ikonis/OpenWatts/docs/hardware/README.md

# OpenWatts RevA hardware exports

These files are generated from the authoritative current-board KiCad sources:

- `OpenWatts-RevA-schematic.pdf` - printable schematic
- `OpenWatts-RevA-schematic.svg` - scalable schematic for browsers/GitHub
- `OpenWatts-RevA-schematic.png` - convenient schematic preview
- `OpenWatts-RevA-front.png` - populated front render
- `OpenWatts-RevA-back.png` - board-back render
- `OpenWatts-RevA-3d.png` - perspective populated-board render

They document the manufactured RevA board. Edit `OpenWatts.kicad_sch` or
`OpenWatts.kicad_pcb` as the source; do not edit these exports as substitutes
for KiCad changes.
