ikonis/OpenWatts/fab/pcbway-2026-07-06/gerbers/OpenWatts-drill-report.txt

Drill report for OpenWatts.kicad_pcb
Created on 2026-07-06T12:25:11

Copper Layer Stackup:
    =============================================================
    L1 :  F.Cu                      front
    L2 :  B.Cu                      back

Drill file 'OpenWatts-PTH.drl' contains
    plated through holes:
    =============================================================
    T1  0.300mm  0.0118"  (30 holes))
    T2  0.600mm  0.0236"  (4 holes)  (with 4 slots)
    T3  0.750mm  0.0295"  (2 holes))
    T4  0.950mm  0.0374"  (8 holes))
    T5  1.000mm  0.0394"  (6 holes))

    Total plated holes count 50

Drill file 'OpenWatts-NPTH.drl' contains
    unplated through holes:
    =============================================================
    T1  0.650mm  0.0256"  (2 holes))
    T2  2.700mm  0.1063"  (4 holes))

    Total unplated holes count 6
