ikonis/OpenWatts/docs/hardware/OpenWatts-RevA-back.png

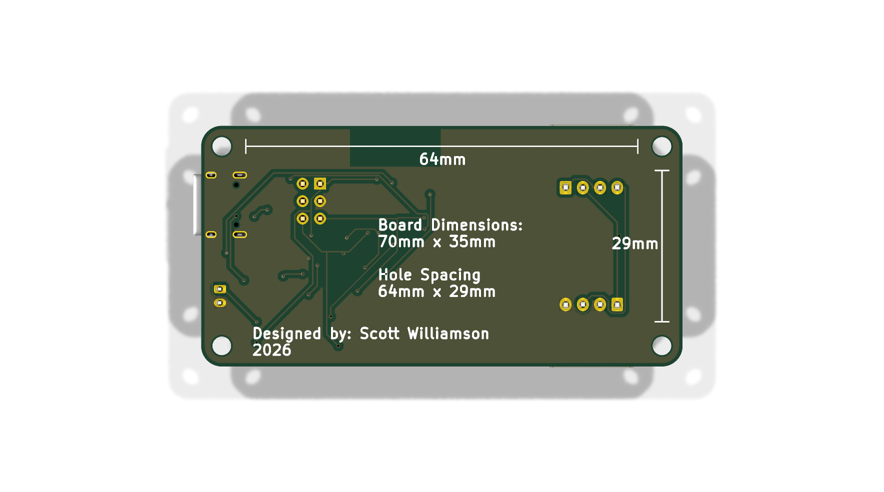
docs/hardware/OpenWatts-RevA-back.png
