ikonis/OpenWatts/docs/hardware/OpenWatts-RevA-front.png

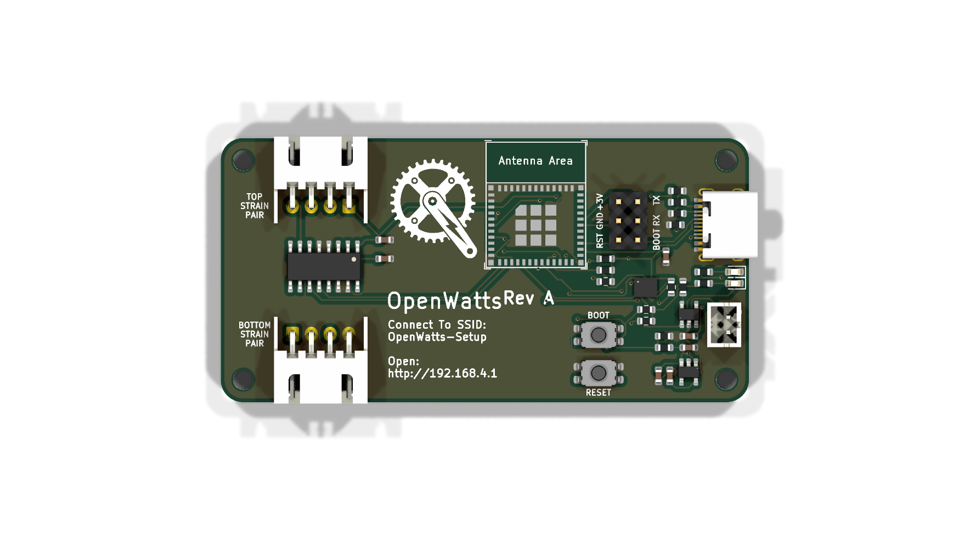
docs/hardware/OpenWatts-RevA-front.png
