ikonis/OpenWatts/docs/hardware/OpenWatts-RevA-schematic.png

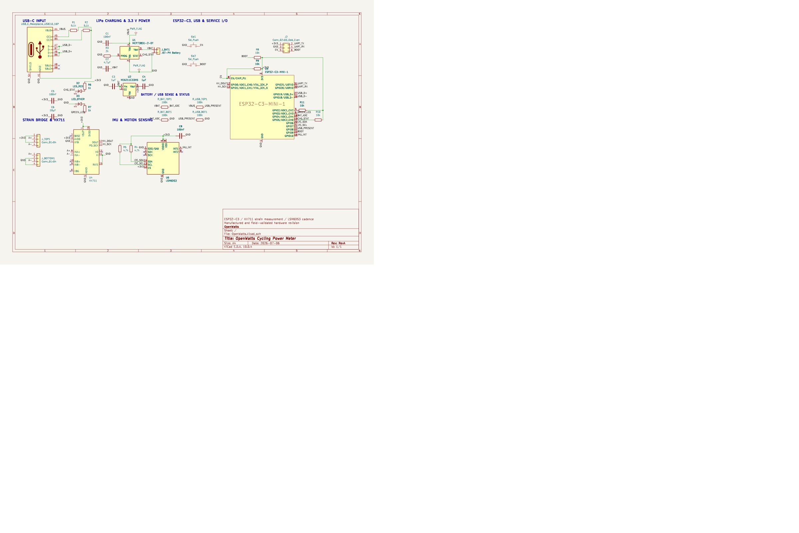
docs/hardware/OpenWatts-RevA-schematic.png
