ikonis/OpenWatts/3dmodels/USB_C_Receptacle_HRO_TYPE-C-31-M-12.step

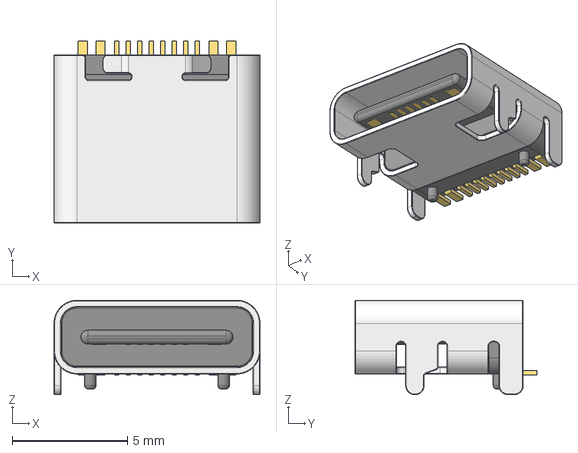
[picture p6: CAD file, 2026-07-06]
3dmodels/USB_C_Receptacle_HRO_TYPE-C-31-M-12.step
8.94 x 7.90 x 4.10 mm
