ikonis/OpenWatts/fab/pcbway-2026-07-06/3d/OpenWatts-board-only.step

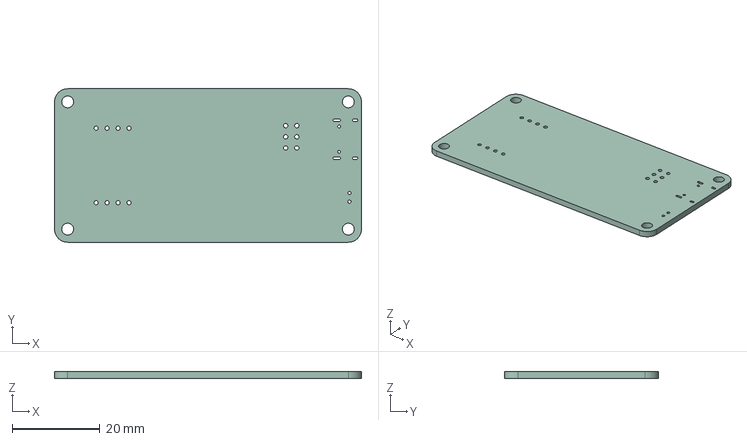
[picture p7: CAD file, 2026-07-06]
fab/pcbway-2026-07-06/3d/OpenWatts-board-only.step
70.0 x 35.0 x 1.51 mm
