ikonis/OpenWatts/mechanical/OW Case.3mf

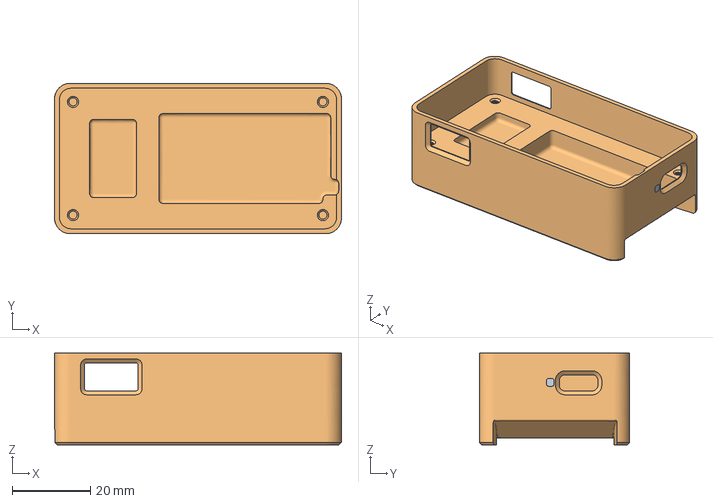
[picture p8: CAD file, 2026-08-10]
mechanical/OW Case.3mf
73.5 x 38.5 x 23.5 mm
Clear
OW Case
