ikonis/OpenWatts/fab/pcbway-2026-07-06/3d/OpenWatts.step

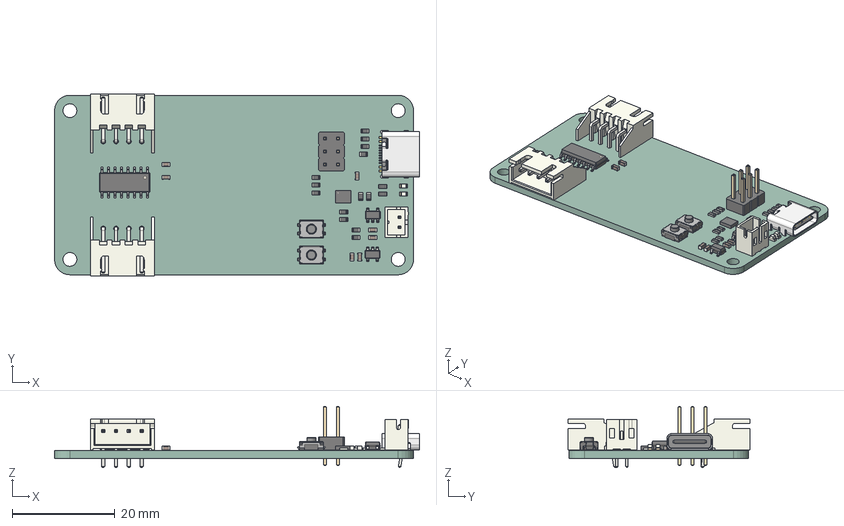
[picture p9: CAD file, 2026-07-06]
fab/pcbway-2026-07-06/3d/OpenWatts.step
71.2 x 35.4 x 11.9 mm
R_0603_1608Metric x 15
SOIC-16_3.9x9.9mm_P1.27mm
SOT-23-5 x 2
C_0603_1608Metric x 7
JST_S4B_XH_A x 2
LGA_14_3x25mm_P05mm_LayoutBorder3x4y
SW_SPST_EVQP2_MiddlePushTravel_H2.5mm x 2
JST_B2B_PH_K
LED_0603_1608Metric x 2
PinHeader_2x03_P254mm_Vertical
USB-C_SMD-TYPE-C-31-M-12
OpenWatts_PCB
