ikonis/OpenWatts/mechanical/OpenWatts_RevA_Enclosure.step

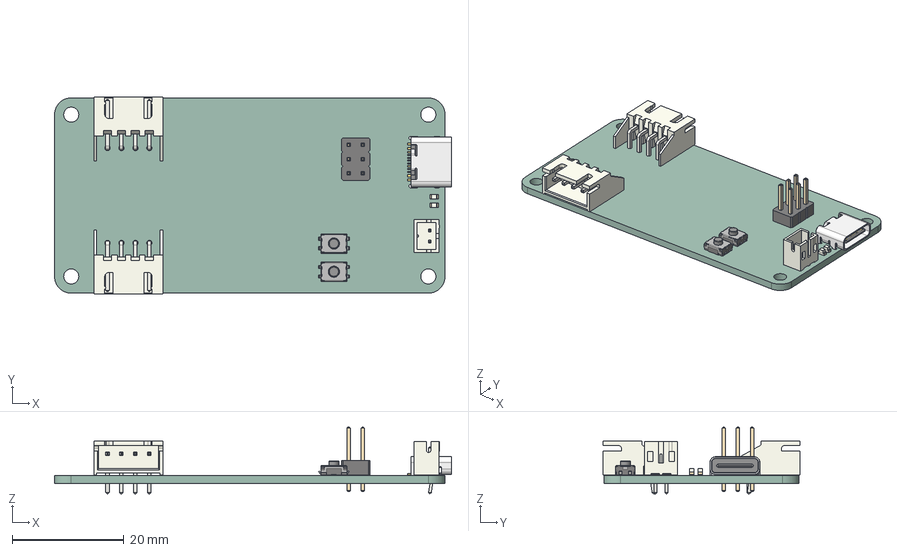
[picture p10: CAD file, 2026-08-10]
mechanical/OpenWatts_RevA_Enclosure.step
71.2 x 35.4 x 11.9 mm
JST_S4B_XH_A x 2
SW_SPST_EVQP2_MiddlePushTravel_H2.5mm x 2
JST_B2B_PH_K
LED_0603_1608Metric x 2
PinHeader_2x03_P254mm_Vertical
USB-C_SMD-TYPE-C-31-M-12
OpenWatts_PCB
