ikonis/OpenWatts/docs/hardware/OpenWatts-RevA-schematic.pdf

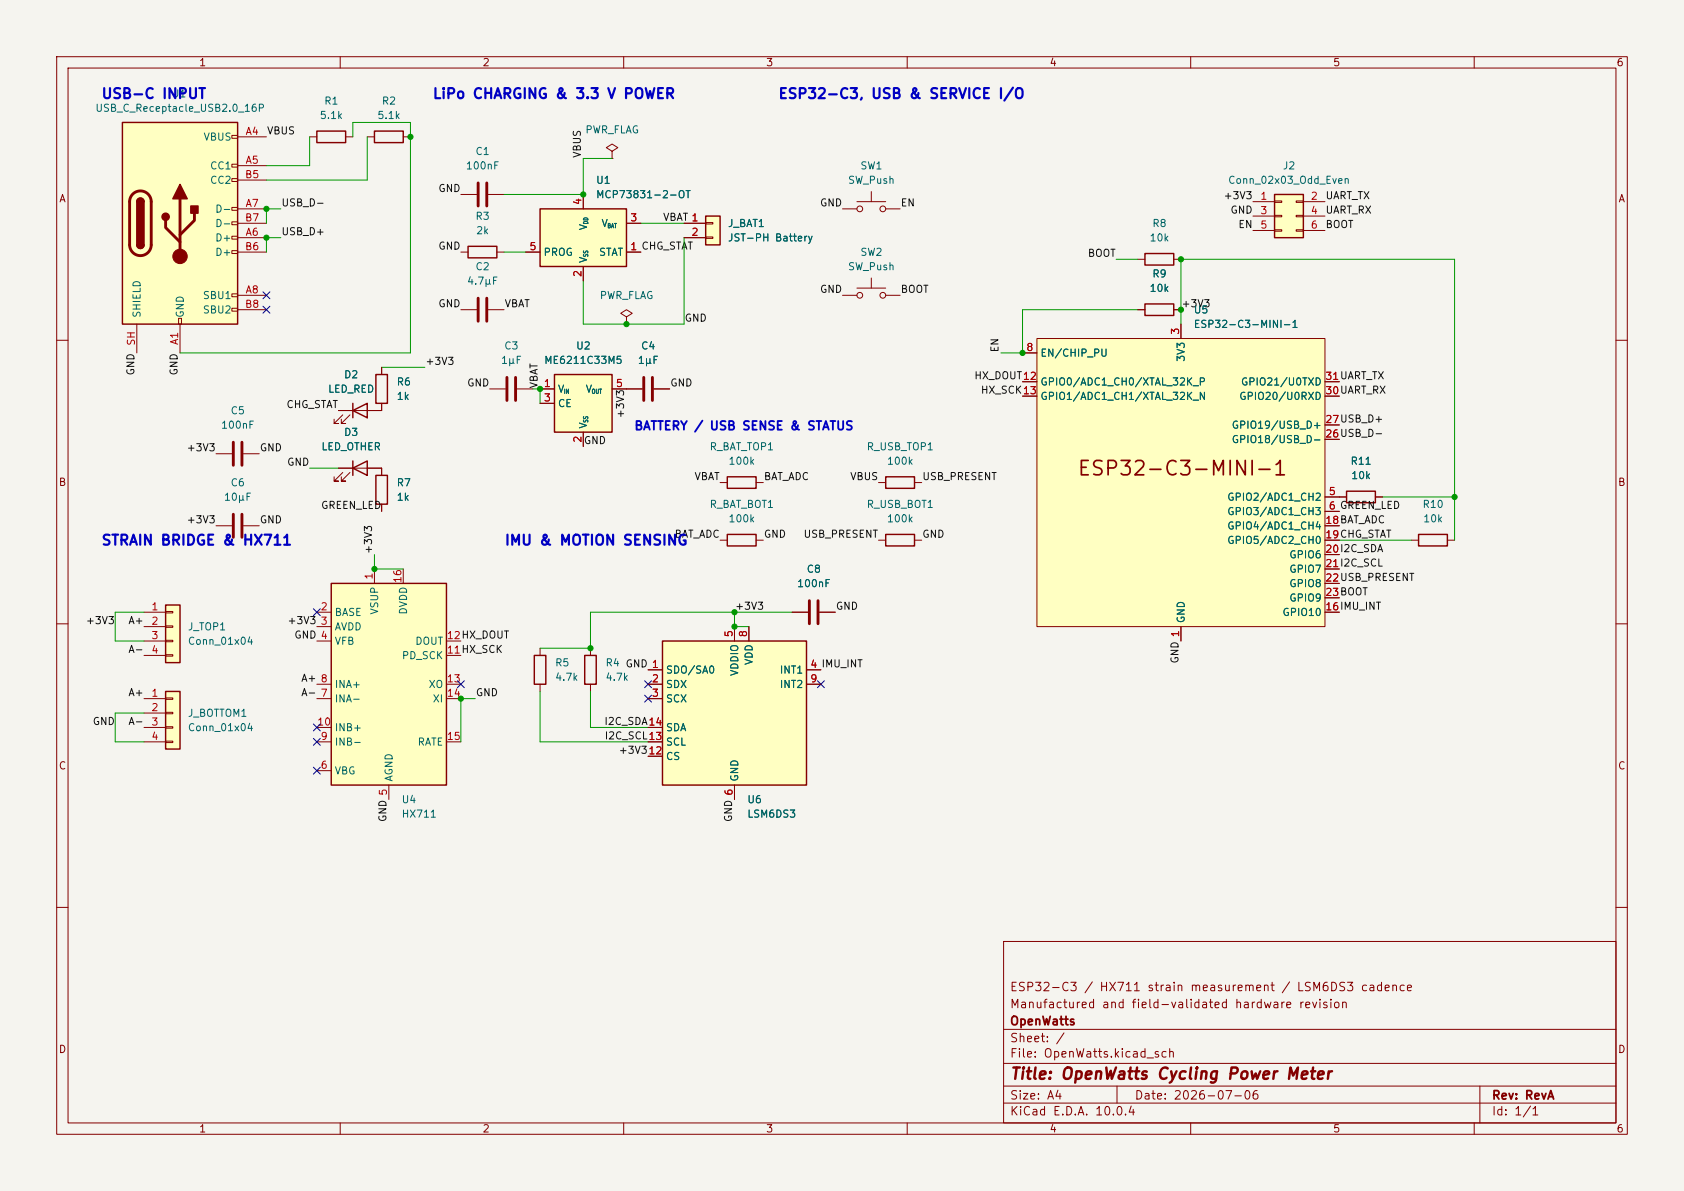
[picture p11: page 1]

BOOT BATTERY / USB SENSE & STATUS

XI 14 RATE 15 DVDD 16 U4HX711 GND A1

ESP32-C3 / HX711 strain measurement / LSM6DS3 cadence
Manufactured and field-validated hardware revision
OpenWatts
Sheet: /
File: OpenWatts.kicad_sch
Title: OpenWatts Cycling Power Meter

Size: A4 | Rev: RevA
KiCad E.D.A. 10.0.4 | Id: 1/1
