ikonis/OpenWatts/OpenWatts.kicad_pcb

## KiCad design OpenWatts.kicad_pcb (2026-07-06)

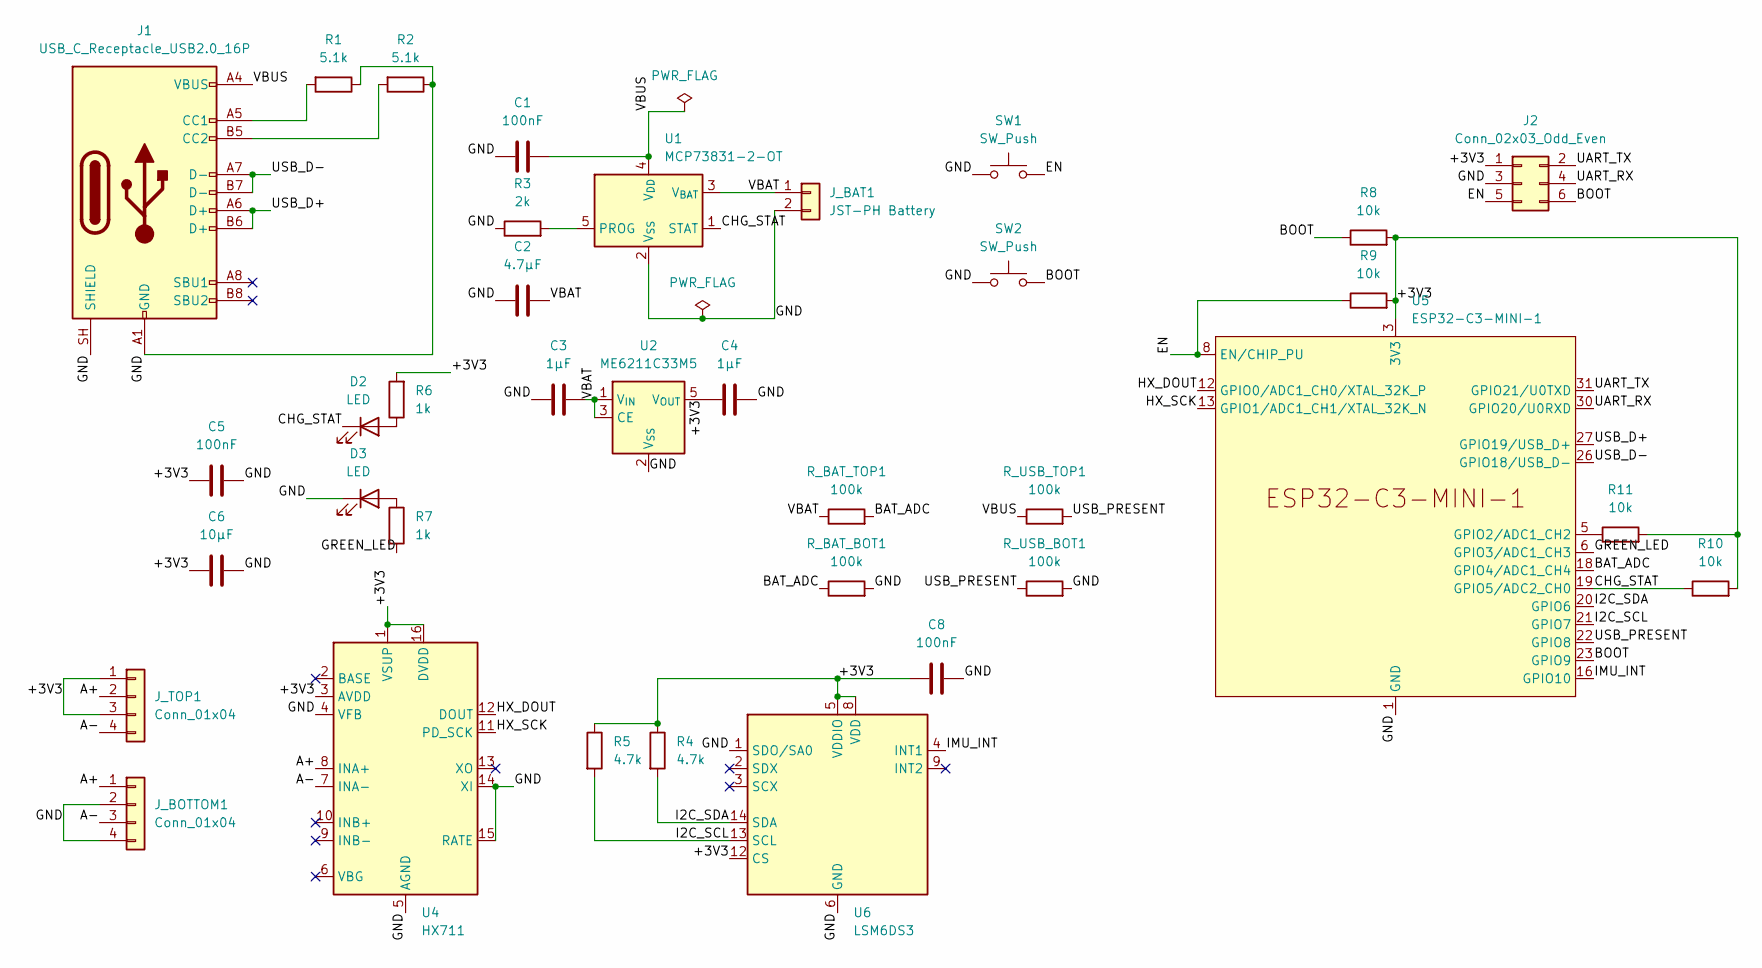
[picture p12: schematic OpenWatts.kicad_sch]

Parts:
C1, C5, C8: 100nF; C_0603_1608Metric
C2: 4.7µF; C_0603_1608Metric
C3, C4: 1µF; C_0603_1608Metric
C6: 10µF; C_0603_1608Metric
D2, D3: LED; LED_0603_1608Metric
J1: USB_C_Receptacle_USB2.0_16P; USB_C_Receptacle_HRO_TYPE-C-31-M-12
J2: Conn_02x03_Odd_Even; PinHeader_2x03_P2.54mm_Vertical
J_BAT1: JST-PH Battery; JST_PH_B2B-PH-K_1x02_P2.00mm_Vertical
J_BOTTOM1: Conn_01x04; JST_XH_S4B-XH-A_1x04_P2.50mm_Horizontal
J_TOP1: Conn_01x04; JST_XH_S4B-XH-A_1x04_P2.50mm_Horizontal
R1, R2: 5.1k; R_0603_1608Metric
R3: 2k; R_0603_1608Metric
R4, R5: 4.7k; R_0603_1608Metric
R6, R7: 1k; R_0603_1608Metric
R8, R9, R10, R11: 10k; R_0603_1608Metric
R_BAT_BOT1: 100k; R_0603_1608Metric
R_BAT_TOP1: 100k; R_0603_1608Metric
R_USB_BOT1: 100k; R_0603_1608Metric
R_USB_TOP1: 100k; R_0603_1608Metric
SW1, SW2: SW_Push; SW_SPST_EVQP2_MiddlePushTravel_H2.5mm
U1: MCP73831-2-OT; SOT-23-5
U2: ME6211C33M5; SOT-23-5
U4: HX711; SOIC-16_3.9x9.9mm_P1.27mm
U5: ESP32-C3-MINI-1
U6: LSM6DS3; LGA-14_3x2.5mm_P0.5mm_LayoutBorder3x4y

Connections:
/+3V3: C4.1, C5.1, C6.1, C8.1, J2.1, J_TOP1.1, J_TOP1.3, R4.1, R5.1, R6.2, R8.2, R9.2, R10.2, R11.2, U2.5 (V_{OUT}), U4.1 (VSUP), U4.3 (AVDD), U4.16 (DVDD), U5.3 (3V3), U6.5 (VDDIO), U6.8 (VDD), U6.12 (CS)
/A+: J_BOTTOM1.1, J_TOP1.2, U4.8 (INA+)
/A-: J_BOTTOM1.3, J_TOP1.4, U4.7 (INA-)
/BAT_ADC: R_BAT_BOT1.1, R_BAT_TOP1.2, U5.18 (GPIO4/ADC1_CH4)
/BOOT: J2.6, R8.1, SW2.2, U5.23 (GPIO9)
/CHG_STAT: D2.1 (K), R10.1, U1.1 (STAT), U5.19 (GPIO5/ADC2_CH0)
/EN: J2.5, R9.1, SW1.2, U5.8 (EN/CHIP_PU)
/GND: C1.1, C2.2, C3.1, C4.2, C5.2, C6.2, C8.2, D3.1 (K), J1.A1 (GND), J1.A12 (GND), J1.B1 (GND), J1.B12 (GND), J1.SH (SHIELD), J2.3, J_BAT1.2, J_BOTTOM1.2, J_BOTTOM1.4, R1.1, R2.1, R3.1, R_BAT_BOT1.2, R_USB_BOT1.2, SW1.1, SW2.1, U1.2 (V_{SS}), U2.2 (V_{SS}), U4.4 (VFB), U4.5 (AGND), U4.14 (XI), U4.15 (RATE), U5.1 (GND), U5.2 (GND), U5.11 (GND), U5.14 (GND), U5.36 (GND), U5.37 (GND), U5.38 (GND), U5.39 (GND), U5.40 (GND), U5.41 (GND), U5.42 (GND), U5.43 (GND), U5.44 (GND), U5.45 (GND), U5.46 (GND), U5.47 (GND), U5.48 (GND), U5.49 (GND), U5.50 (GND), U5.51 (GND), U5.52 (GND), U5.53 (GND), U6.1 (SDO/SA0), U6.6 (GND), U6.7 (GND)
/GREEN_LED: R7.2, U5.6 (GPIO3/ADC1_CH3)
/HX_DOUT: U4.12 (DOUT), U5.12 (GPIO0/ADC1_CH0/XTAL_32K_P)
/HX_SCK: U4.11 (PD_SCK), U5.13 (GPIO1/ADC1_CH1/XTAL_32K_N)
/I2C_SCL: R5.2, U5.21 (GPIO7), U6.13 (SCL)
/I2C_SDA: R4.2, U5.20 (GPIO6), U6.14 (SDA)
/IMU_INT: U5.16 (GPIO10), U6.4 (INT1)
/UART_RX: J2.4, U5.30 (GPIO20/U0RXD)
/UART_TX: J2.2, U5.31 (GPIO21/U0TXD)
/USB_D+: J1.A6 (D+), J1.B6 (D+), U5.27 (GPIO19/USB_D+)
/USB_D-: J1.A7 (D-), J1.B7 (D-), U5.26 (GPIO18/USB_D-)
/USB_PRESENT: R_USB_BOT1.1, R_USB_TOP1.2, U5.22 (GPIO8)
/VBAT: C2.1, C3.2, J_BAT1.1, R_BAT_TOP1.1, U1.3 (V_{BAT}), U2.1 (V_{IN}), U2.3 (CE)
/VBUS: C1.2, J1.A4 (VBUS), J1.A9 (VBUS), J1.B4 (VBUS), J1.B9 (VBUS), R_USB_TOP1.1, U1.4 (V_{DD})
unnamed: D2.2 (A), R6.1
unnamed: D3.2 (A), R7.1
unnamed: J1.A5 (CC1), R1.2
unnamed: J1.B5 (CC2), R2.2
unnamed: R3.2, U1.5 (PROG)
unnamed: R11.1, U5.5 (GPIO2/ADC1_CH2)

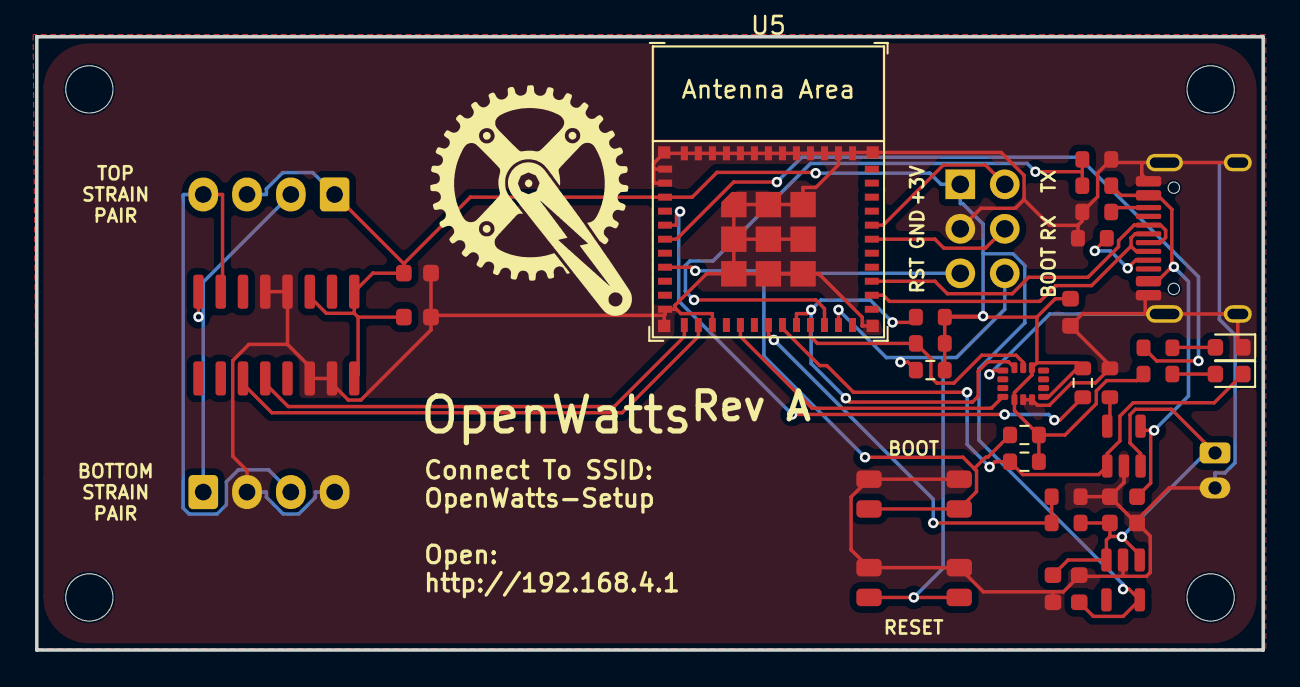
[picture p13: board OpenWatts.kicad_pcb from above]

Board: 2 copper layers, 70.0 x 35.0 mm, 40 parts (0 on the bottom side), 27 nets.

Other parts of the board:
H1, H2, H3, H4: MountingHole_2.7mm_M2.5
