ikonis/OpenWatts/firmware/logo_asset.cpp

#include "logo_asset.h"

namespace openwatts::webui {

const char kLogoSvg[] = R"OWSVG(<svg xmlns="http://www.w3.org/2000/svg" viewBox="-6.286433 -6.928326 12.505216 14.162086" fill="currentColor">
<path d="M -2.51636,-1.243183 L -2.44591,-1.273985 L -2.391271,-1.32609 L -2.355731,-1.393018 L -2.345133,-1.462328 L -2.356549,-1.529495 L -2.387047,-1.589994 L -2.433696,-1.6393 L -2.493568,-1.672888 L -2.56373,-1.686233 L -2.620708,-1.68038 L -2.691601,-1.651454 L -2.745989,-1.599748 L -2.772223,-1.55571 L -2.794392,-1.480759 L -2.79074,-1.40794 L -2.764022,-1.342221 L -2.716993,-1.288569 L -2.652408,-1.251951 L -2.596487,-1.238911 Z"/>
<path d="M -2.515681,4.069298 L -2.454675,4.045565 L -2.404457,4.005514 L -2.367293,3.953187 L -2.345451,3.892624 L -2.3412,3.827866 L -2.356806,3.762954 L -2.394537,3.701928 L -2.440927,3.659521 L -2.49164,3.636216 L -2.555002,3.625201 L -2.616853,3.628463 L -2.633053,3.63254 L -2.698402,3.667321 L -2.747795,3.722845 L -2.77778,3.794004 L -2.785475,3.858106 L -2.773916,3.935769 L -2.738974,3.996884 L -2.680051,4.042379 L -2.660985,4.051651 L -2.585207,4.072674 Z"/>
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
</svg>
)OWSVG";

}  // namespace openwatts::webui
