ikonis/OpenWatts/firmware/src/settings_storage.h

#pragma once

#include "config.h"
#include "ride_log.h"
#include "esp_err.h"

namespace openwatts {

class SettingsStorage {
public:
    esp_err_t begin();
    DeviceConfig load();
    esp_err_t save(const DeviceConfig &config);
    esp_err_t markSelfTestDone(DeviceConfig &config);
    LastRideSummary loadLastRide();
    esp_err_t saveLastRide(const LastRideSummary &summary);

private:
    bool initialized_ = false;
};

}  // namespace openwatts
