ikonis/OpenWatts/firmware/src/web_ui.h

#pragma once

namespace openwatts::webui {

extern const char kStatusPage[];
extern const char kRidePage[];
extern const char kSettingsPage[];
extern const char kCalibrationPage[];
extern const char kOtaPage[];
extern const char kDiagnosticsPage[];

}  // namespace openwatts::webui
