ikonis/OpenWatts/(commit log)

2026-07-06 Initial OpenWatts fabrication package
    [OpenWatts-BOM.csv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]
2026-07-06 Add OpenWatts firmware scaffold
    [partitions.csv]
2026-07-06 Ignore local KiCad lock files
2026-07-06 Add OpenWatts production export files
    [bom.csv, designators.csv, positions.csv]
2026-07-25 Checkpoint OpenWatts motion-wake firmware and board outputs
    [OpenWatts.kicad_sch, bom.csv]
2026-07-28 v0.2.0 - Establish OpenWatts parity architecture
    - Pin ESP32-C3 ESP-IDF and RISC-V toolchain versions
    - Add shared runtime, battery, and report policy contracts
    - Harden CPS power encoding and reject invalid samples before filtering
    - Add replaceable median/EMA power estimator
    - Preserve v3 credentials and calibration through NVS v4 migration
    - Scaffold honest IMU rotation and completed-revolution interfaces
    - Add architecture tests and hardware validation documentation
    [battery_policy.cpp, battery_policy.h, ble_cycling_power.cpp, ble_cycling_power.h, cadence_estimator.cpp, cadence_estimator.h, config.h, main.cpp]
2026-08-06 Checkpoint validated OpenWatts bring-up and configuration parity
    [partitions.csv]
2026-08-06 Establish OpenWatts pre-install firmware baseline
    - Add persistent Normal and Maintenance operating modes
    - Complete maintenance WebUI, calibration, OTA, diagnostics, and branding
    - Add IMU tuning and installation validation scaffolding
    - Preserve battery reporting, sleep, BLE, and sensor runtime behavior
    - Document and test the pre-install architecture
2026-08-10 Checkpoint OpenWatts pre-calibration bring-up
    - Preserve validated USB, Wi-Fi, motion wake, WebUI, and LED behavior
    - Add current installation documentation and mechanical exports
    - Correct HX711 readiness accounting and measured sample telemetry
    [OW Case.3mf, OpenWatts_RevA_Assembly.step, OpenWatts_RevA_Enclosure.step]
2026-08-11 OpenWatts 0.9-rc1 pre-install firmware
    - clean obsolete prototype and bench-test paths
    - wire persistent product settings into runtime behavior
    - add calibration-gated Ride Zero and Last Ride history
    - publish retained Last Ride metrics through MQTT discovery
    - add OpenWatts Home Assistant documentation
    - validate product and diagnostic builds
2026-08-11 Release OpenWatts 1.0.0 with guarded battery OTA
2026-08-11 Release OpenWatts 1.0.10 ride stability and road estimates
    - stabilize IMU cadence across transient read failures and reverse spikes
    - make Ride Zero lifecycle-aware and avoid repeated NVS writes
    - allow Manual Tare from the normal Status interface
    - add reproducible flat-road speed and distance estimates
    - add Imperial/Metric presentation with SI-native MQTT telemetry
    - migrate configuration and legacy Last Ride records safely
    - expand firmware tests and current architecture documentation
    [cadence_estimator.cpp, cadence_estimator.h, config.h, main.cpp, mqtt_notifier.cpp, mqtt_notifier.h, power_estimator.cpp]
2026-08-12 checkpoint: preserve validated OpenWatts pre-cleanup state
    Capture the working cadence and BLE diagnostics, ESP32-C3 gyro-range correction, and bounded post-ride MQTT publication behavior before the production cleanup pass.
    [ble_cycling_power.cpp, ble_cycling_power.h, cadence_estimator.cpp, cadence_estimator.h, config.h, imu_lsm6ds3.cpp, main.cpp]
2026-08-12 Release OpenWatts 1.0.12 production cleanup
    - preserve bounded post-ride MQTT delivery before sleep
    - remove unused runtime and rotation prototype modules
    - refresh architecture, installation, Home Assistant, and firmware documentation
    - remove the development-only installation checklist from the device UI
    - retain deployed NVS layout compatibility and calibration data
    - update tests to cover the active IMU cadence architecture
2026-08-12 Add live OpenWatts ride dashboard
    - expose current ride time, distance, and modeled speed
    - keep Normal-mode Wi-Fi available for qualified rides
    - poll SmartSpin2K runtime data directly from the browser
    - add a compact phone-first Ride page with safe fallback values
    - preserve BLE CPS and existing post-ride sleep/report lifecycle
2026-08-14 v1.1.0 - Mark OpenWatts as a working product
    - Remove unused SmartSpin2K target resistance display
    - Promote the validated RevA firmware to 1.1.0
    - Refresh documentation for current ride, OTA, MQTT, and validation behavior
    - Establish the post-installation product baseline
2026-08-14 Present OpenWatts RevA for public release
    - Add a concise public README and human-readable RevA BOM
    - Polish the schematic with functional headings and manufactured-board metadata
    - Add PDF, SVG, front, back, and 3D public hardware assets
    - Preserve evidence-based future hardware lessons in isolated RevB notes
    - Remove local KiCad sessions, redundant exports, and unused artwork
    - Keep the manufactured PCB and electrical connectivity unchanged
    [OpenWatts.dsn, OpenWatts.kicad_sch]
2026-08-14 Remove deployment-specific MQTT broker default
    [config.h]
2026-08-31 WIP: calibration drift investigation and UI updates
    [openwatts-imu-capture (1).csv, openwatts-imu-capture (2).csv]
2026-08-31 Add in-ride sliding zero correction for strain drift
    Tracks the per-revolution dead-spot torque minimum as a proxy for zero
    drift while riding, applying a bounded, gradually-walked correction on
    top of the permanent calibration. Exposes a ride log over HTTP for
    diagnostics.
    [config.h, main.cpp, power_estimator.cpp, power_estimator.h, setup_wifi.cpp, setup_wifi.h]
2026-08-31 Remove accidental local artifacts from repo
    nvs_before_recovery.bin and the imu-capture csvs were local test/debug
    output swept in by a prior commit; not needed in version control.
    [openwatts-imu-capture (1).csv, openwatts-imu-capture (2).csv]
2026-08-31 Add mDNS advertisement, sliding-zero intensity setting, and Ride tab layout fix
    - Advertise the device at http://openwatts.local via mDNS so it doesn't
    need to be found by IP; started/torn down alongside Wi-Fi.
    - Expose sliding-zero correction as a Settings toggle + intensity
    percentage (maps to sliding_zero_correction_fraction) instead of a
    firmware-only constant.
    - Ride tab: resistance/shift position are now a 2-column row with
    control mode spanning both columns beneath, replacing the previous
    4-column grid that only ever held 3 cells.
    [setup_wifi.cpp]
2026-09-01 v1.3.0 - Settings/Calibration UI cleanup, calibration verify-before-save, MQTT backoff
    - Settings page: reorganized into focused cards (Network now includes the
    mDNS hostname; Power & Sleep absorbs motion sensitivity; Save Last Ride
    and Ride Behavior split apart; Engineering moved to Diagnostics, off by
    default). Masonry-style packing for card grids so uneven card heights
    don't leave large gaps.
    - Calibration page: dropped the physical-signal-confirmation gate, reordered
    actions to Capture Zero -> Capture Loaded -> Verify Known -> Save
    Calibration -> Discard/Reverse/Reset, and relaxed the calibration state
    machine so Verify can run before Save (matching that order). Trimmed the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
    [calibration.cpp, config.h, main.cpp, mqtt_notifier.cpp, setup_wifi.cpp, setup_wifi.h]
2026-09-01 Fix: zero acceptance (manual tare or auto Ride Zero) leaves sliding-zero correction stale
    manualTare() and the automatic Ride Zero accept path both re-anchor
    zero_offset_counts, but neither cleared the in-ride sliding-zero
    correction that had already accumulated against the old zero. That stale
    correction kept being added back into every torque sample afterward,
    so a fresh tare consistently settled a Nm or two off instead of ~0.
    Both paths now call PowerEstimator::resetSlidingZero() when a new zero is
    accepted, matching the reset that already happens when a ride locks in.
    [main.cpp, setup_wifi.cpp]
2026-09-01 Fix MQTT battery reports never publishing, add settings intensity unit bug fix and Restart Device button
    MQTT: publishDiscovery() ran synchronously on connect before the actual
    telemetry publish, so the 17-message HA discovery burst could consume the
    whole 15s connection watchdog before the tracked publish ever went out.
    Every connection died mid-discovery-burst and was never marked succeeded,
    so g_mqtt_discovery_pending never cleared and every reconnect repeated the
    same losing race -- the device has never successfully published telemetry
    since firmware 1.1.0. Publish the real payload first and treat discovery
    as a best-effort follow-up once that succeeds.
    Settings: sliding-zero "Correctio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
    [mqtt_notifier.cpp, setup_wifi.cpp]
2026-09-03 Sliding-zero: suppress correction learning during real high-effort revolutions
    The correction loop tracked only the per-revolution torque minimum against a
    learned baseline, assuming genuine drift is the only thing that moves it. A
    hard effort (a sprint, a standing surge) also raises the minimum -- the
    rider never fully unloads through the dead spot -- and the loop couldn't
    tell the two apart, so short high-effort bursts got walked in as if they
    were zero drift and had to be manually tared out mid-ride.
    Track the per-revolution peak alongside the existing minimum and compare
    the peak-to-trough range against a learned baseline range. Real effort
    widens that range (asymmetric loading, more fo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
    [power_estimator.cpp, power_estimator.h, setup_wifi.cpp]
